Scottapotamas/antispark-switch/README.md

# antispark-switch

High current mosfet based switch for soft-starting capacitive loads.

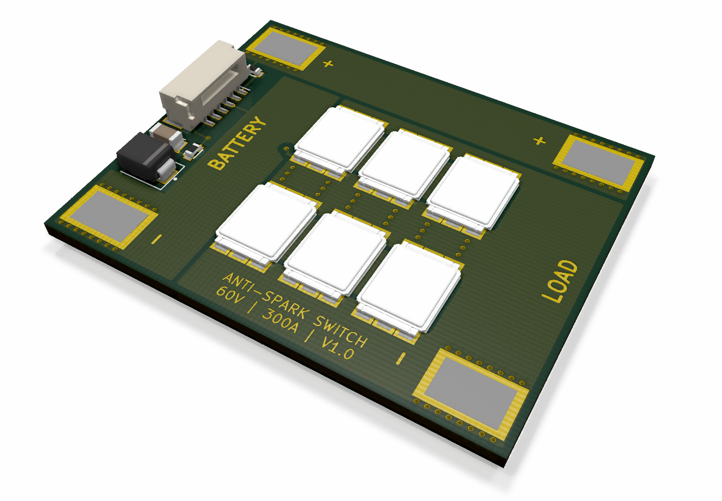
[picture p1: renders/iso.png]
Iso Render Isometric Render


This is going to be interesting to assemble...
