Scottapotamas/antispark-switch/renders/top.png

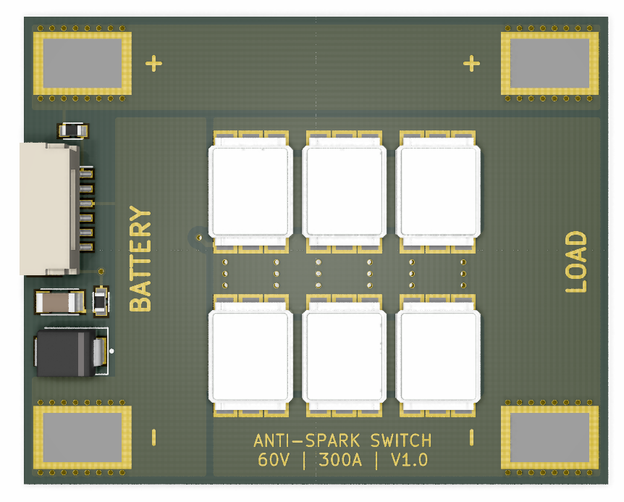
renders/top.png
