Scottapotamas/antispark-switch/antispark-sch.pdf

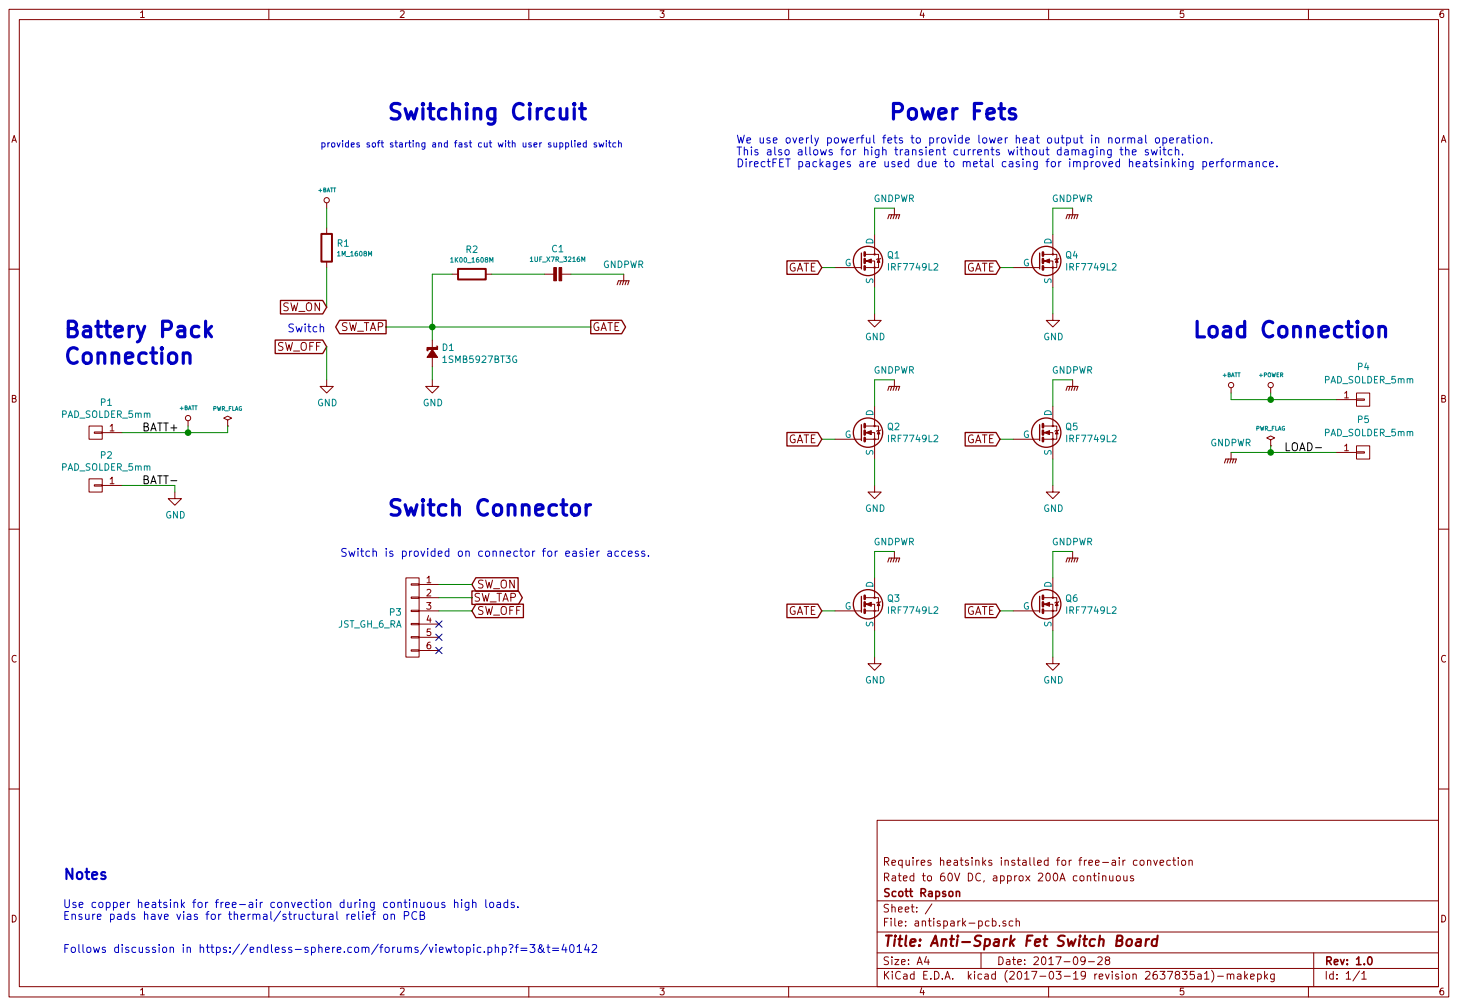
[picture p3: page 1]

provides soft starting and fast cut with user supplied switch 1 P1 PAD_SOLDER_5mm

We use overly powerful fets to provide lower heat output in normal operation.
This also allows for high transient currents without damaging the switch.

Switch is provided on connector for easier access. D1

Requires heatsinks installed for free-air convection
Rated to 60V DC, approx 200A continuous
File: antispark-pcb.sch Sheet: / Scott Rapson

Use copper heatsink for free-air convection during continuous high loads.
Ensure pads have vias for thermal/structural relief on PCB

Id: 1/1 Title: Anti-Spark Fet Switch Board

Follows discussion in https://endless-sphere.com/forums/viewtopic.php?f=3&t=40142
