Scottapotamas/antispark-switch/antispark-pcb/antispark-pcb.sch

## KiCad design antispark-pcb/antispark-pcb.sch (2017-09-28)

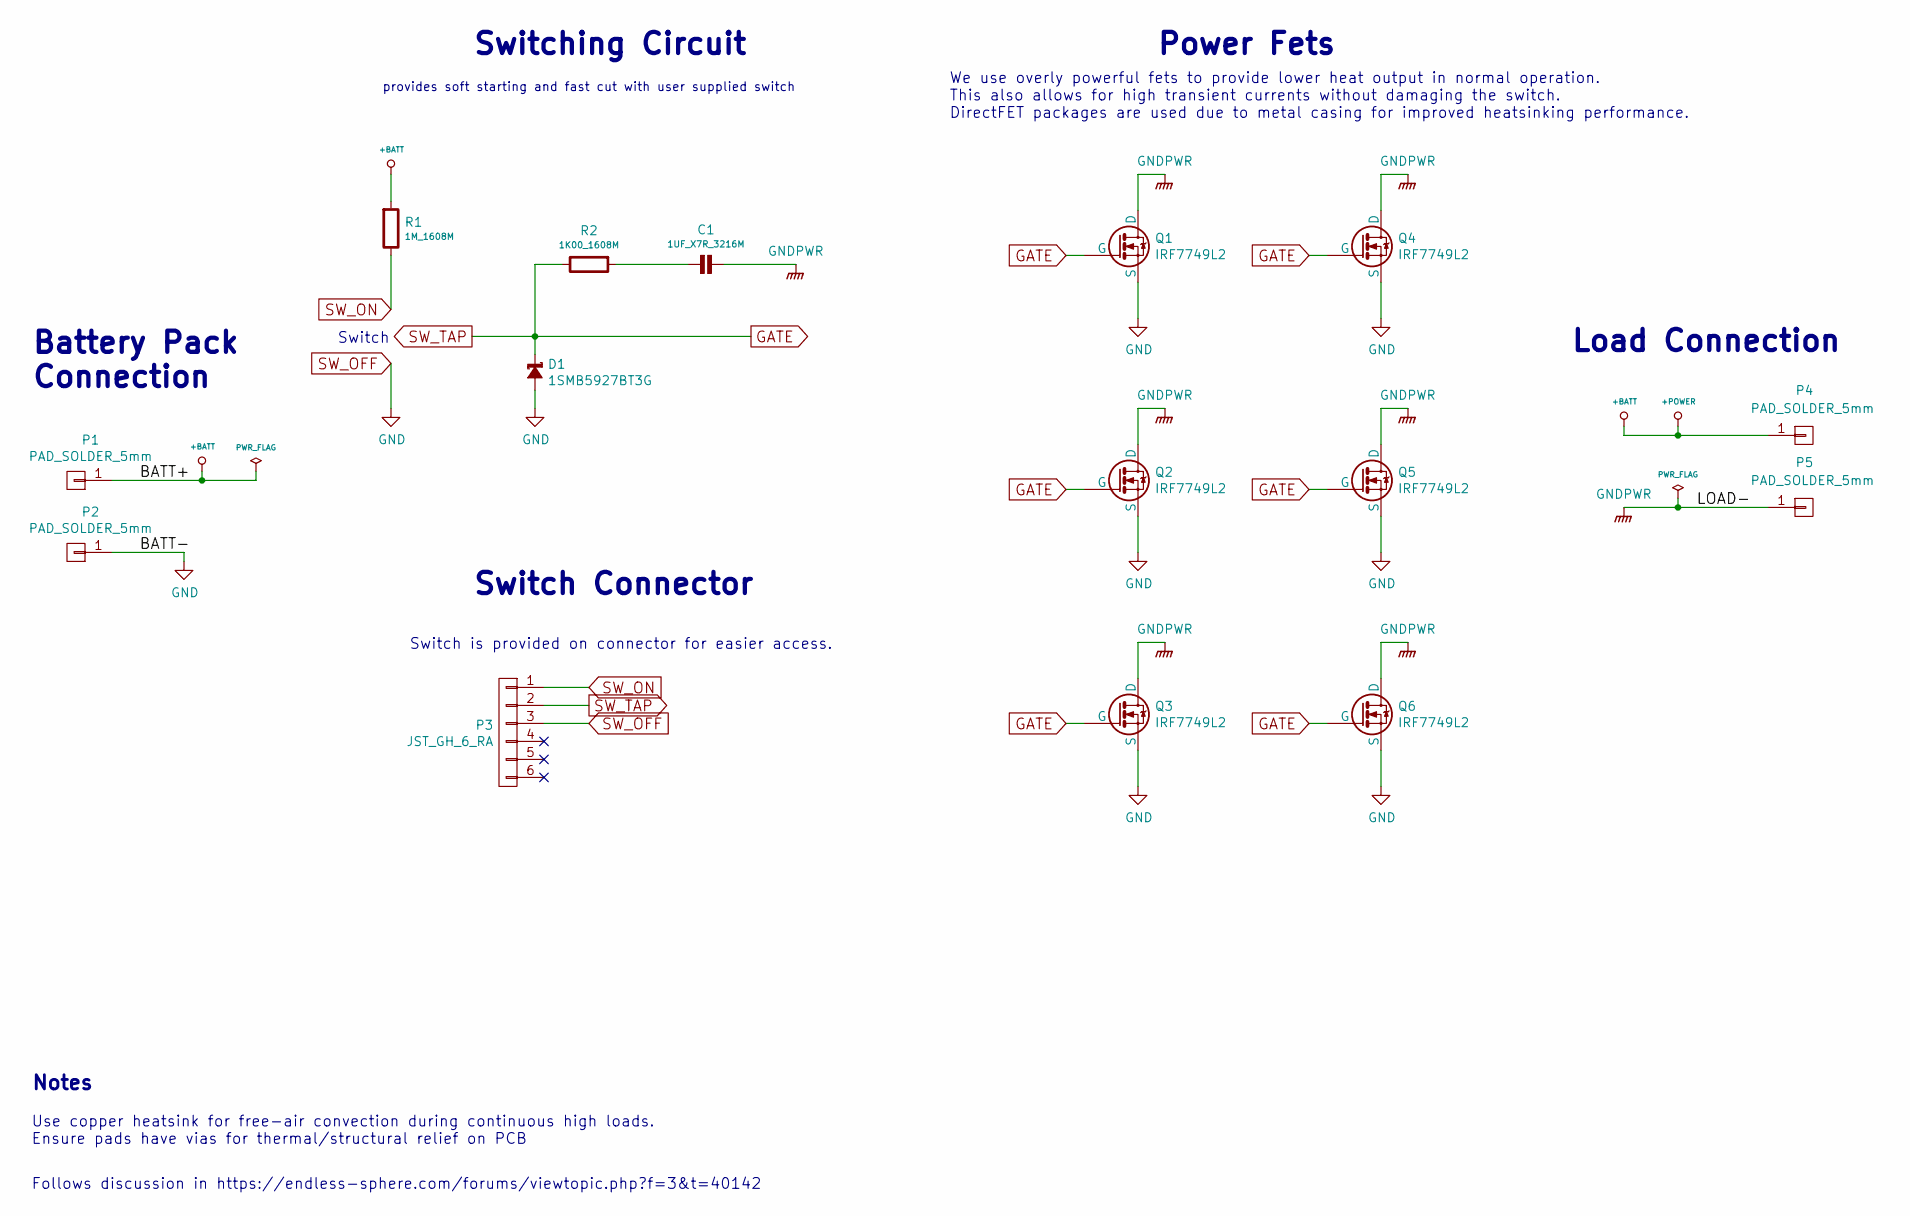
[picture p4: schematic antispark-pcb.sch]

Parts:
C1: 1UF_X7R_3216M; CAPC3216X135N
D1: 1SMB5927BT3G; SODFL5336X245N
P1, P2, P4, P5: PAD_SOLDER_5mm
P3: JST_GH_6_RA; SM06B-GHS-TB
Q1, Q2, Q3, Q4, Q5, Q6: IRF7749L2; directFET_L8
R1: 1M_1608M; RESC1608X50N
R2: 1K00_1608M; RESC1608X50N

Connections:
+BATT: P1.1, P4.1, R1.1
GATE: D1.C, P3.2, Q1.G, Q2.G, Q3.G, Q4.G, Q5.G, Q6.G, R2.2
GND: D1.A, P2.1, P3.3, Q1.S, Q2.S, Q3.S, Q4.S, Q5.S, Q6.S
GNDPWR: C1.1, P5.1, Q1.D, Q2.D, Q3.D, Q4.D, Q5.D, Q6.D
unnamed: C1.2, R2.1
SW_ON: P3.1, R1.2

Notes on the sheet:
Battery Pack Connection
Load Connection
Switching Circuit
Power Fets
We use overly powerful fets to provide lower heat output in normal operation. This also allows for high transient currents without damaging the switch. DirectFET packages are used due to metal casing for improved heatsinking performance.
Switch
Switch Connector
Switch is provided on connector for easier access.
Follows discussion in https://endless-sphere.com/forums/viewtopic.php?f=3&t=40142
Use copper heatsink for free-air convection during continuous high loads. Ensure pads have vias for thermal/structural relief on PCB
Notes
provides soft starting and fast cut with user supplied switch
