Scottapotamas/antispark-switch/(commit log)

2017-09-28 Schematic and PCB roughed out
    Parts, design, layout mostly completed.
    Most cosmetics added.
    [antispark-pcb.kicad_pcb, antispark-pcb.sch]
2017-09-28 Minor tidy and positioning of text
    Cleanup of pours and text locations for cleaner appearance.
    [antispark-pcb.kicad_pcb]
2017-09-28 Added renders and pdf of schematic
2017-10-06 Added gerber files
    [antispark-pcb-B.Cu.gbr, antispark-pcb-B.Mask.gbr, antispark-pcb-B.SilkS.gbr, antispark-pcb-Edge.Cuts.gbr, antispark-pcb-F.Cu.gbr, antispark-pcb-F.Mask.gbr, antispark-pcb-F.SilkS.gbr, antispark-pcb-NPTH-drl_map.gbr]
2017-10-06 Added BoM
    [antispark-pcb-BOM.csv]
